motcore/animo/docs/walker-sim/img/duck_v1_cad.png

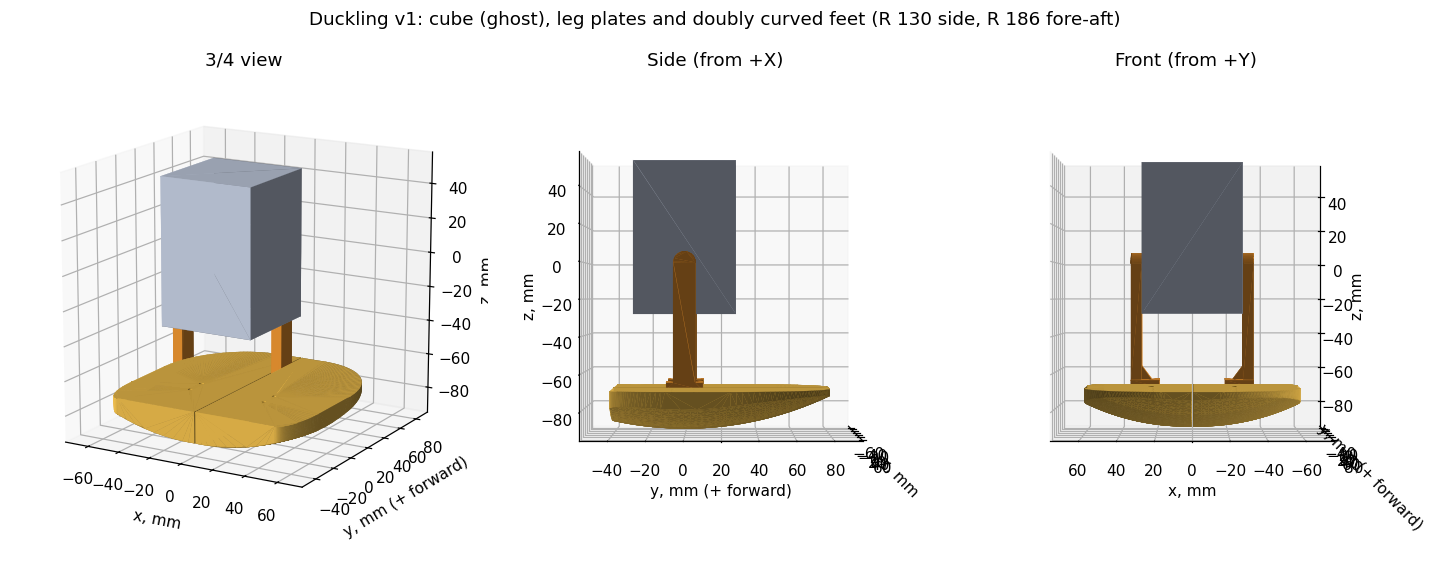
docs/walker-sim/img/duck_v1_cad.png
