motcore/animo/cad/stl/animo_dial/PETG/animo_dial_Pointer.stl

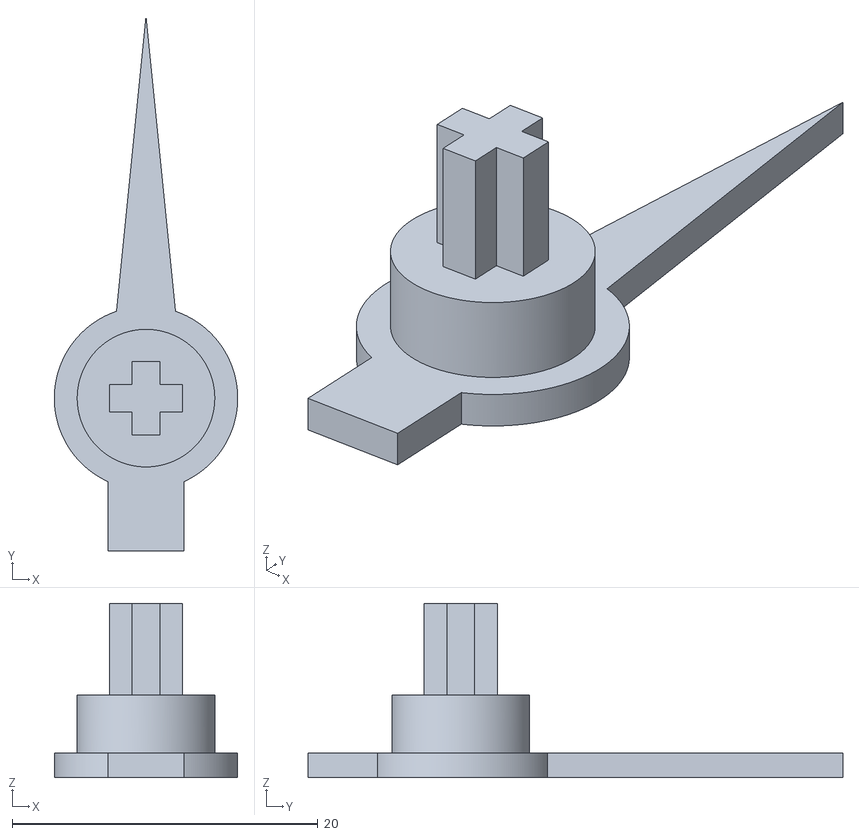
[picture p22: CAD file, 2026-11-01]
cad/stl/animo_dial/PETG/animo_dial_Pointer.stl
12.0 x 35.0 x 11.4
