motcore/animo/cad/stl/animo_duck/PETG/animo_duck_Plate.stl

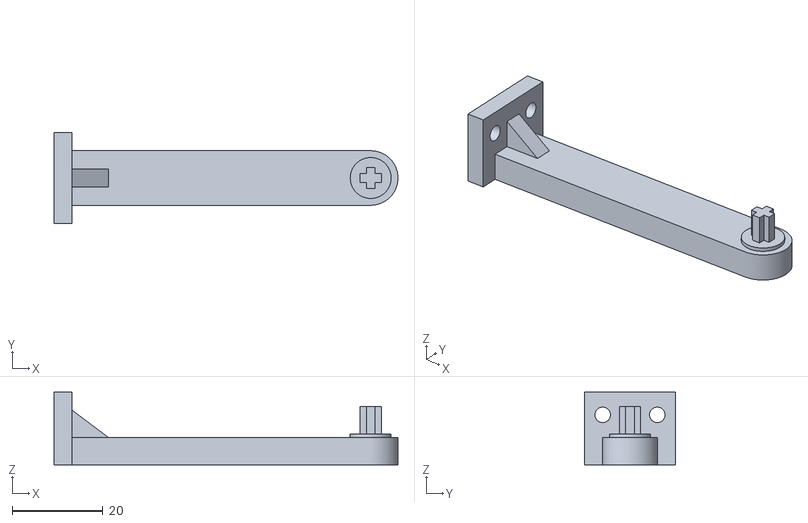
[picture p23: CAD file, 2026-11-02]
cad/stl/animo_duck/PETG/animo_duck_Plate.stl
75.6 x 20.0 x 16.0
