motcore/animo/cad/stl/animo_trex/PETG/animo_trex_LegRight.stl

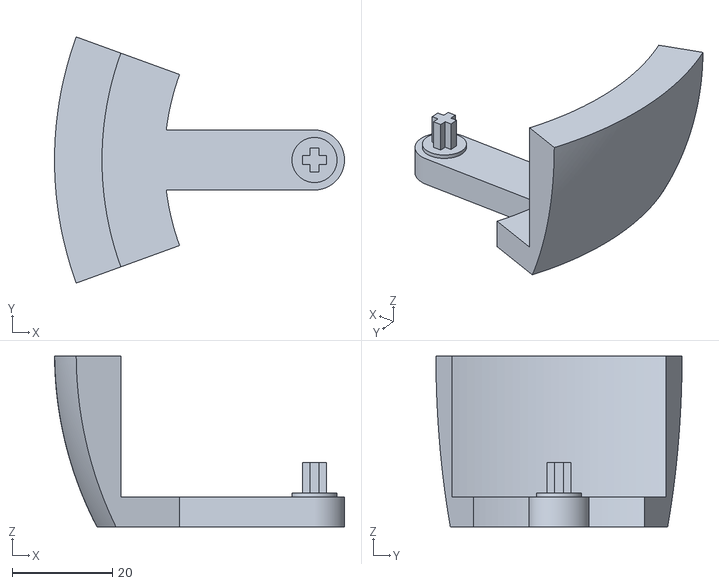
[picture p24: CAD file, 2026-10-28]
cad/stl/animo_trex/PETG/animo_trex_LegRight.stl
58.0 x 49.3 x 34.1
