motcore/animo/cad/stl/animo_v2/PETG/animo_v2_OutputHub.stl

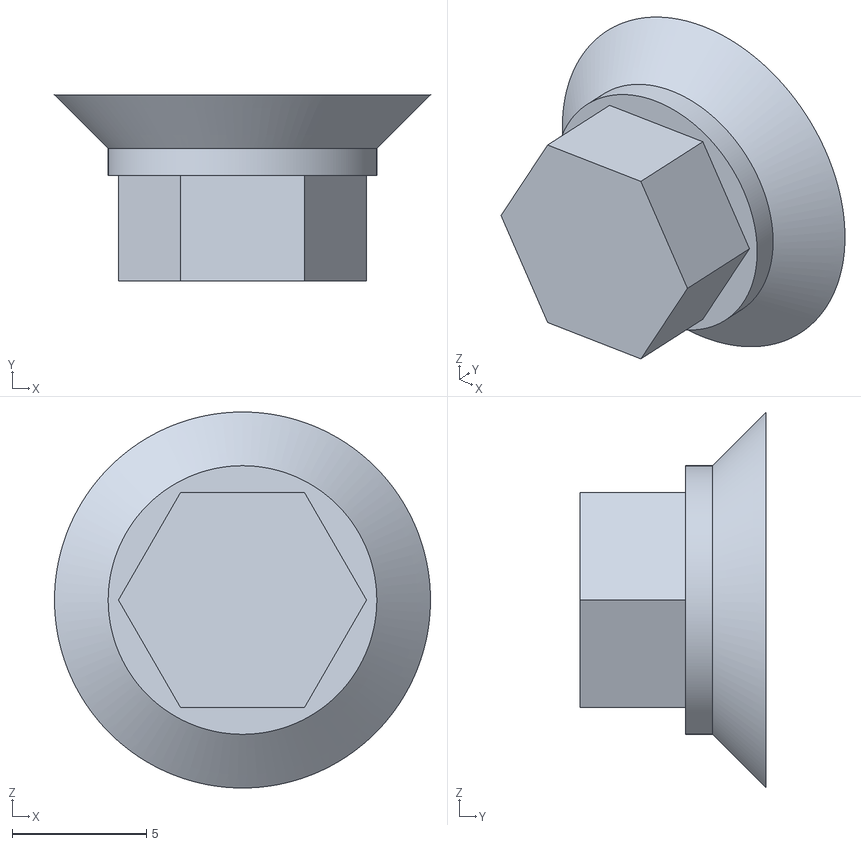
[picture p25: CAD file, 2026-10-28]
cad/stl/animo_v2/PETG/animo_v2_OutputHub.stl
14.0 x 6.94 x 14.0
