motcore/animo/cad/stl/coupon/animo_fit_technic_pin.stl

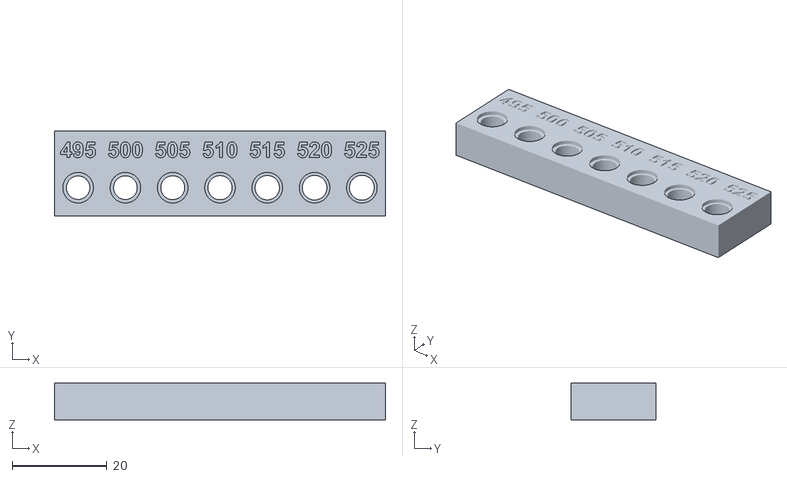
[picture p26: CAD file, 2026-10-20]
cad/stl/coupon/animo_fit_technic_pin.stl
70.0 x 18.0 x 7.80
