motcore/animo/cad/stl/animo_dial/PETG/animo_dial_Dial.stl

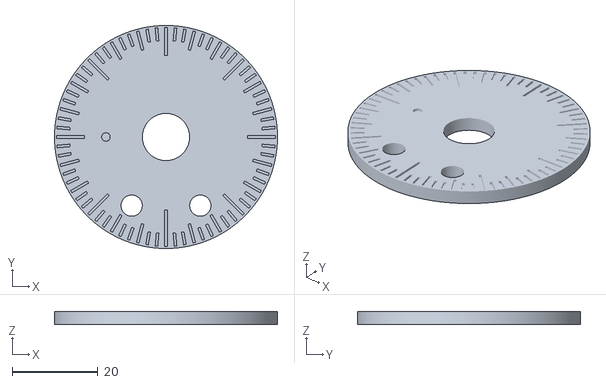
[picture p27: CAD file, 2026-11-01]
cad/stl/animo_dial/PETG/animo_dial_Dial.stl
52.0 x 52.0 x 3.00
