motcore/animo/cad/stl/animo_duck/PETG/animo_duck_SpigotCoupon.stl

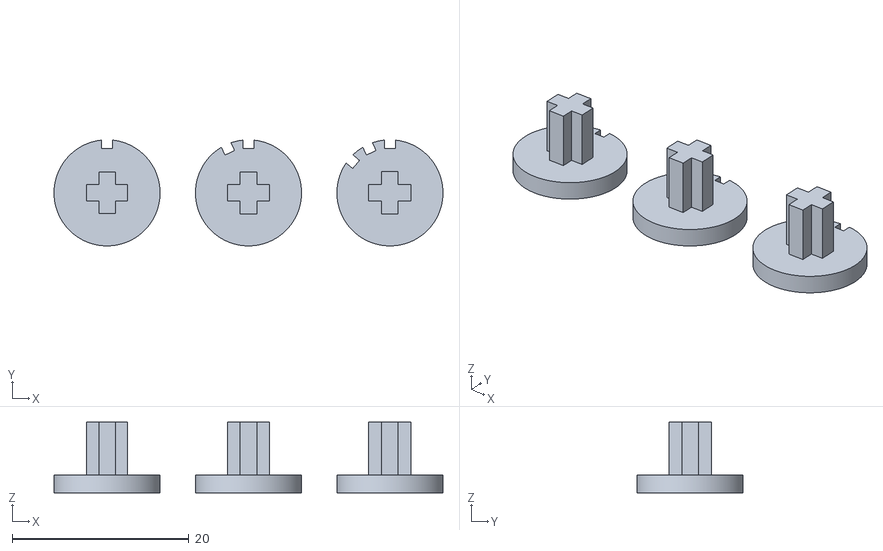
[picture p28: CAD file, 2026-11-02]
cad/stl/animo_duck/PETG/animo_duck_SpigotCoupon.stl
44.0 x 12.0 x 8.00
