motcore/animo/cad/stl/animo_v2/PETG/animo_v2_BrainBase.stl

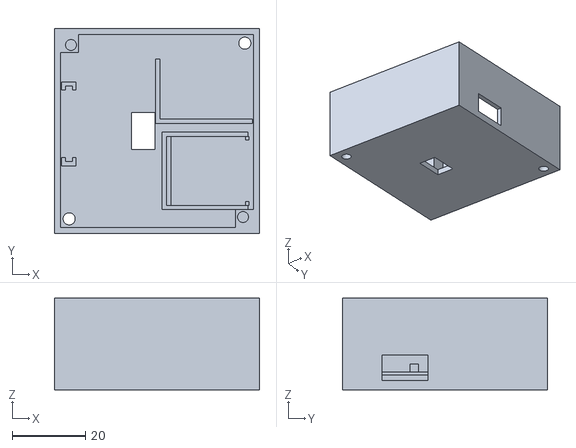
[picture p29: CAD file, 2026-10-25]
cad/stl/animo_v2/PETG/animo_v2_BrainBase.stl
56.0 x 56.0 x 25.0
