motcore/animo/cad/stl/coupon/animo_fit_technic_cross.stl

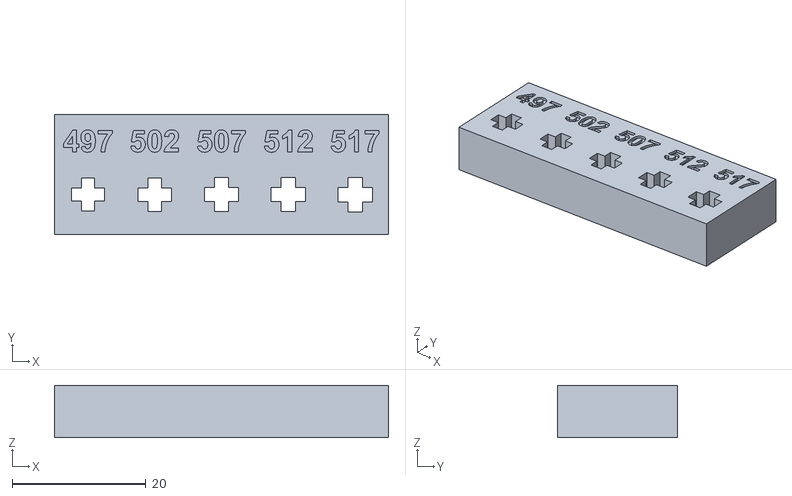
[picture p30: CAD file, 2026-10-20]
cad/stl/coupon/animo_fit_technic_cross.stl
50.0 x 18.0 x 7.80
