motcore/animo/cad/stl/animo_duck/PETG/animo_duck_FootRight.stl

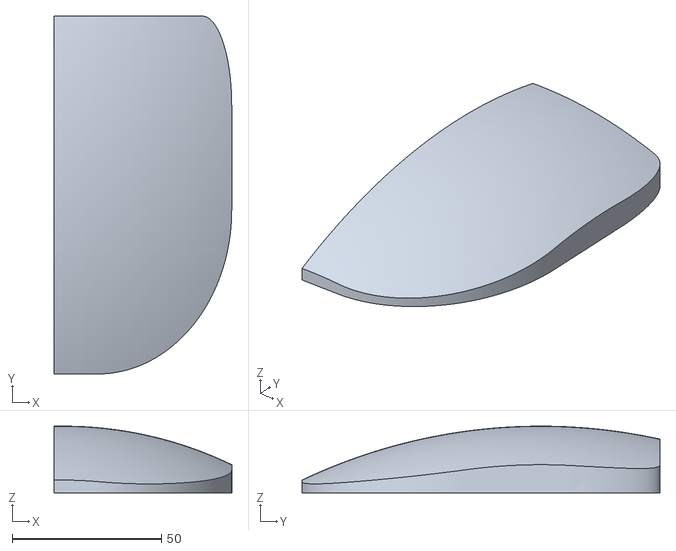
[picture p31: CAD file, 2026-11-02]
cad/stl/animo_duck/PETG/animo_duck_FootRight.stl
59.5 x 120.0 x 22.4
