motcore/animo/cad/stl/animo_trex/PETG/animo_trex_Tail.stl

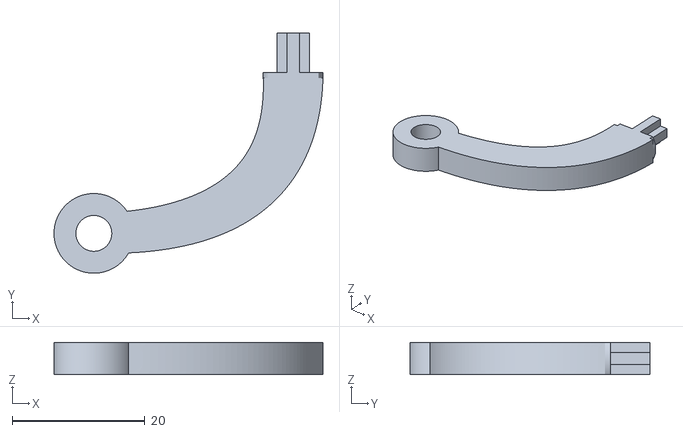
[picture p32: CAD file, 2026-10-28]
cad/stl/animo_trex/PETG/animo_trex_Tail.stl
40.5 x 36.2 x 4.86
