motcore/animo/cad/stl/animo_v2/PETG/animo_v2_BrainLid.stl

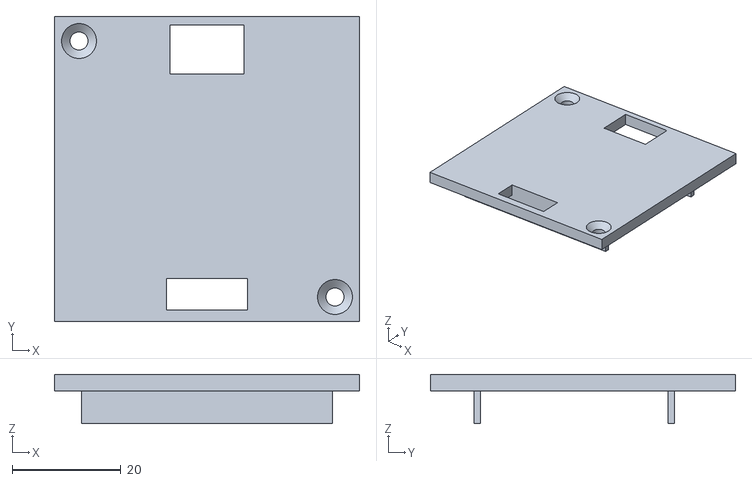
[picture p33: CAD file, 2026-10-23]
cad/stl/animo_v2/PETG/animo_v2_BrainLid.stl
56.0 x 56.0 x 9.00
