motcore/animo/cad/stl/coupon/animo_fit_mini_female_round.stl

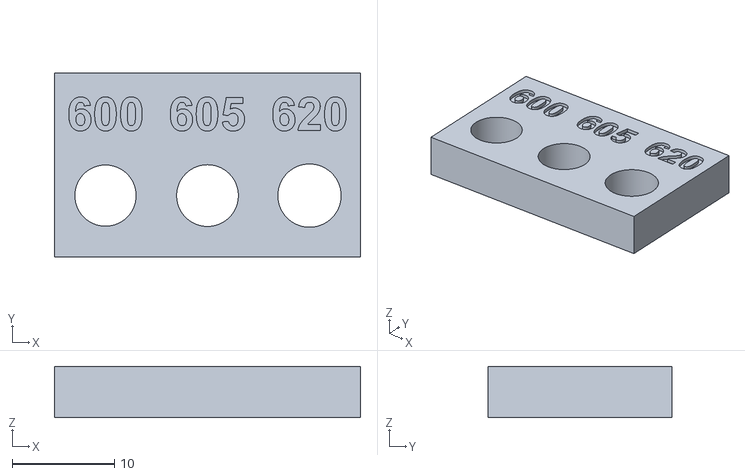
[picture p34: CAD file, 2026-10-20]
cad/stl/coupon/animo_fit_mini_female_round.stl
30.0 x 18.0 x 5.00
