motcore/animo/cad/stl/animo_v2/PETG/animo_v2_Deck.stl

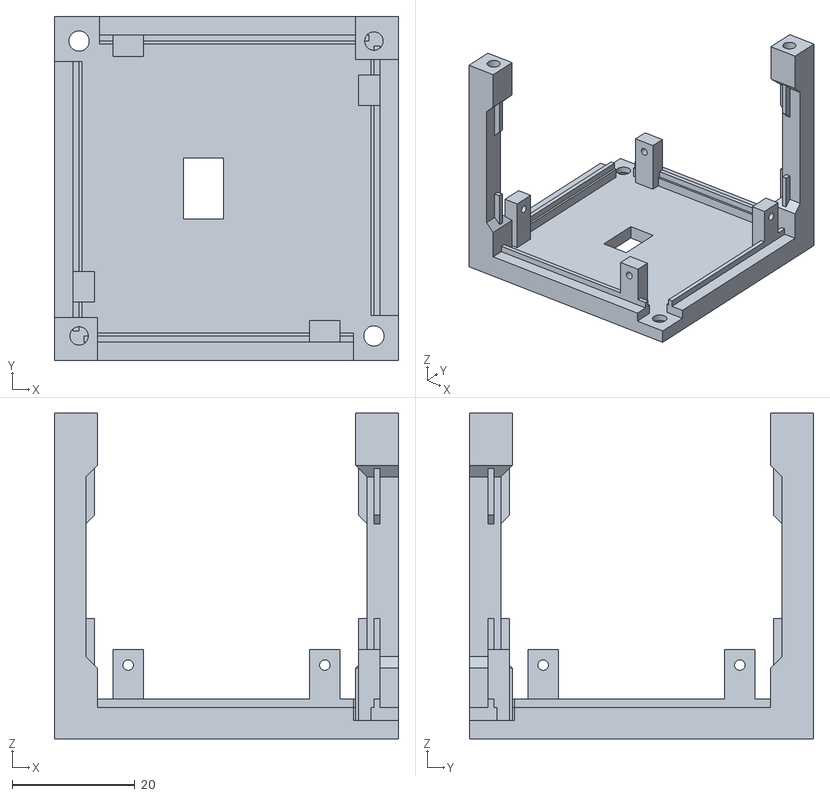
[picture p35: CAD file, 2026-10-20]
cad/stl/animo_v2/PETG/animo_v2_Deck.stl
56.0 x 56.0 x 53.0
