motcore/animo/cad/stl/coupon/animo_fit_mini_male_round.stl

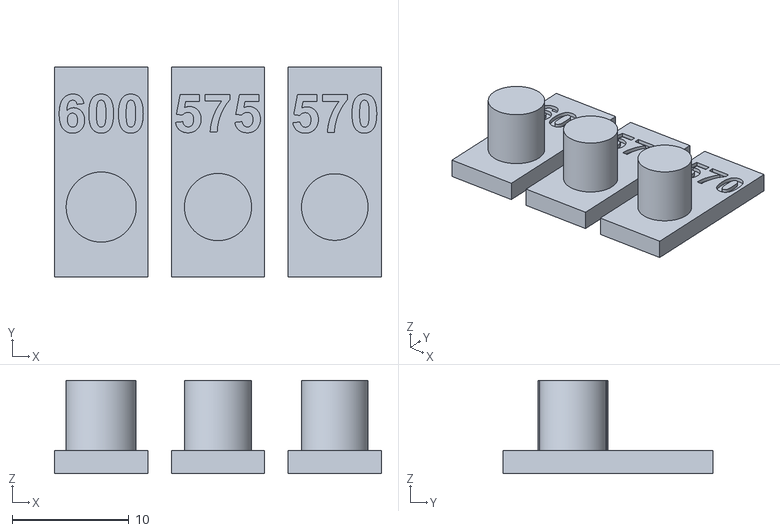
[picture p36: CAD file, 2026-10-20]
cad/stl/coupon/animo_fit_mini_male_round.stl
28.0 x 18.0 x 8.00
