motcore/animo/cad/stl/animo_v2/PETG/animo_v2_Wall.stl

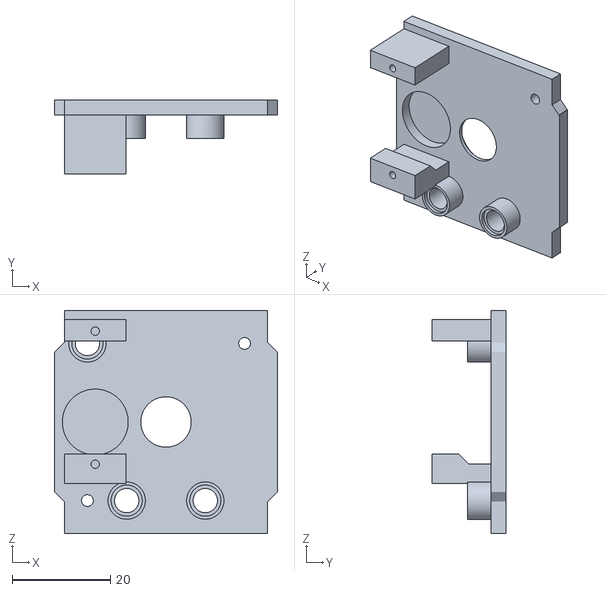
[picture p37: CAD file, 2026-10-20]
cad/stl/animo_v2/PETG/animo_v2_Wall.stl
45.4 x 15.0 x 45.4
