motcore/animo/cad/stl/animo_v2/PETG/animo_v2_OutputGear.stl

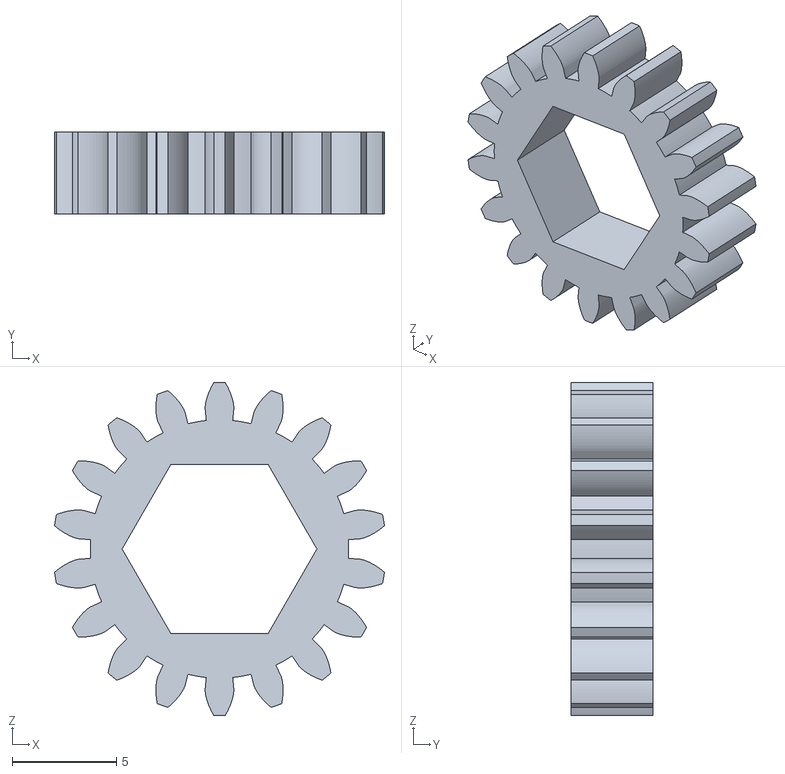
[picture p38: CAD file, 2026-10-20]
cad/stl/animo_v2/PETG/animo_v2_OutputGear.stl
15.8 x 3.94 x 16.0
