motcore/animo/cad/stl/animo_v2/PETG/animo_v2_ServoGear.stl

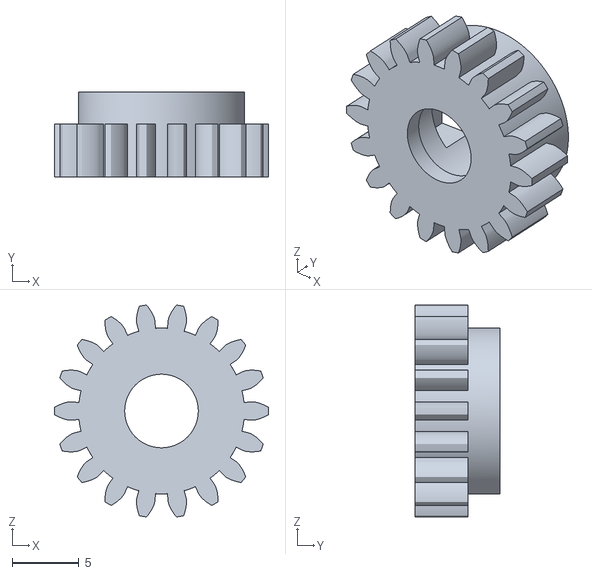
[picture p39: CAD file, 2026-10-20]
cad/stl/animo_v2/PETG/animo_v2_ServoGear.stl
16.0 x 6.34 x 15.8
