motcore/animo/(list of files, cad)

Other CAD files:
cad/stl/animo_trex/PETG/animo_trex_LegLeft.stl
cad/stl/animo_duck/PETG/animo_duck_FootLeft.stl
cad/stl/animo_trex/PETG/animo_trex_SpigotCoupon.stl
cad/stl/coupon/animo_fit_male_round.stl
cad/stl/coupon/animo_fit_male_square.stl
cad/stl/coupon/animo_fit_female_round.stl
cad/stl/coupon/animo_fit_female_square.stl
cad/stl/animo_v1/PETG/animo_v1_ModelArm.stl
cad/stl/animo_v1/PETG/animo_v1_ModelBase.stl
cad/stl/animo_v1/PETG/animo_v1_ModelShaft.stl
cad/stl/animo_v1/PETG/animo_v1_ModelShaft_D5.7.stl
cad/stl/animo_v1/PETG/animo_v1_OutputHub.stl
cad/stl/animo_v1/PETG/animo_v1_Wall.stl
cad/stl/animo_v1/PLA/animo_v1_ModelArm.stl
cad/stl/animo_v1/PLA/animo_v1_ModelBase.stl
cad/stl/animo_v1/PLA/animo_v1_ModelShaft.stl
cad/stl/animo_v1/PLA/animo_v1_ModelShaft_D5.7.stl
cad/stl/animo_v1/PLA/animo_v1_OutputHub.stl
cad/stl/animo_v1/PLA/animo_v1_ServoGear.stl
cad/stl/animo_v1/PLA/animo_v1_Wall.stl
