motcore/animo/cad/animo_fit_coupon.py

# Animo — fit coupon: round and square, a female strip and loose male pins each
# FreeCAD Python Macro
#
# Settles the PLA fits in one print instead of trial and error (user,
# 2026-10-18). Each feature is labelled with its DRAWN size in hundredths
# ("590" = 5.90), so a pair's drawn clearance is hole minus pin:
#   - FEMALE strip: holes 5.90 ... 6.40, through a 5 mm plate.
#   - MALE set: pins 6.10 ... 5.60, 6 mm tall, each on its own loose tile so
#     any pin goes into any hole (on one strip they only fit all at once).
# The two ranges overlap by 0.20 both ways, so the change from press to
# slide falls inside the coupon whatever the printer does to each.
# Try the 600 pin in every hole and every pin in the 600 hole: the first gives
# how holes print, the second how outsides print, so the macros can set
# both. For each, note: does not go in / press (by hand) / slides / turns
# with play. Square = the flat faces of the hex and the D.
#
# Printed as they lie: holes and pins vertical, like the parts they stand for.
# Run headless:
#   "C:/Program Files/FreeCAD 1.0/bin/freecadcmd.exe" animo_fit_coupon.py

import FreeCAD as App
import Part
import os

STEP    = 0.05    # mm
HOLES   = (5.90, 6.40)   # mm — first and last
PINS    = (6.10, 5.60)
N       = 11
PITCH   = 10.0    # mm between features
PLATE_T = 5.0     # mm — female plate
BASE_T  = 2.0     # mm — male tiles' base
PIN_H   = 6.0     # mm
WIDTH   = 18.0    # mm — strip width: feature row + label row
ROW_Y   = 6.0     # mm — feature centres from the strip's edge
LABEL_Y = 14.0    # mm — label centres
LABEL_H = 3.5     # mm — text height
TILE_W  = 8.0     # mm — male tiles, PITCH apart: 2 mm between them
ENGRAVE = 0.4     # mm
FONT    = "C:/Windows/Fonts/arialbd.ttf"

v = App.Vector


def feature(shape, size, x, z0, z1):
    """A round or square prism, vertical, centred at (x, ROW_Y)."""
    h = z1 - z0
    if shape == "round":
        return Part.makeCylinder(size / 2.0, h, v(x, ROW_Y, z0))
    return Part.makeBox(size, size, h, v(x - size / 2.0, ROW_Y - size / 2.0, z0))


def label(text, x, z_top):
    """Engraving cutter for `text`, centred at (x, LABEL_Y), from the top."""
    wires = Part.makeWireString(text, FONT, LABEL_H)
    faces = []
    for char in wires:
        for f in Part.makeFace(char, "Part::FaceMakerBullseye").Faces:
            faces.append(f)
    comp = Part.makeCompound(faces)
    bb = comp.BoundBox
    comp.translate(v(x - (bb.XMin + bb.XMax) / 2.0,
                     LABEL_Y - (bb.YMin + bb.YMax) / 2.0, z_top - ENGRAVE))
    return comp.extrude(v(0, 0, ENGRAVE + 1.0))


def length():
    return N * PITCH


def _sizes(first, sign):
    return [round(first + sign * i * STEP, 2) for i in range(N)]


def female(shape, sizes=None):
    sizes = sizes or _sizes(HOLES[0], 1)
    plate = Part.makeBox(len(sizes) * PITCH, WIDTH, PLATE_T)
    for i, size in enumerate(sizes):
        x = PITCH / 2.0 + i * PITCH
        plate = plate.cut(feature(shape, size, x, -1, PLATE_T + 1))
        plate = plate.cut(label(f"{round(size * 100)}", x, PLATE_T))
    return plate.removeSplitter()


def male(shape, sizes=None):
    sizes = sizes or _sizes(PINS[0], -1)
    tiles = []
    for i, size in enumerate(sizes):
        x = PITCH / 2.0 + i * PITCH
        tile = Part.makeBox(TILE_W, WIDTH, BASE_T, v(x - TILE_W / 2.0, 0, 0))
        tile = tile.cut(label(f"{round(size * 100)}", x, BASE_T))
        pin = feature(shape, size, x, BASE_T - 0.01, BASE_T + PIN_H)
        tiles.append(tile.fuse(pin).removeSplitter())
    return Part.makeCompound(tiles)


PARTS = [(f"{kind}_{shape}", (female if kind == "female" else male)(shape))
         for shape in ("round", "square") for kind in ("female", "male")]
# Mini coupon (2026-10-20): just the pieces that compared the two readings,
# to reprint quickly with another seam setting.
MINI_HOLES = [6.00, 6.05, 6.20]
MINI_PINS  = [6.00, 5.75, 5.70]
PARTS += [("mini_female_round", female("round", MINI_HOLES)),
          ("mini_male_round", male("round", MINI_PINS))]

# LEGO Technic coupon (2026-10-20): holes for real LEGO friction pins and
# axles, one module deep (7.8, a beam's thickness), the pin holes with a
# counterbore on both faces as on a LEGO beam. Labelled with the drawn size; the cube's macro
# draws them at LEGO size + 0.27 in PETG (pin 5.07, cross 5.07 / 2.07).
TECH_T      = 7.8
TECH_PINS   = [4.95, 5.00, 5.05, 5.10, 5.15, 5.20, 5.25]
TECH_CROSS  = [4.97, 5.02, 5.07, 5.12, 5.17]     # tip to tip; arms = tip - 3.0
TECH_CB     = (6.47, 0.8)                        # counterbore, as on the wall


def cross_z(span, arm, x, z0, z1):
    a = Part.makeBox(span, arm, z1 - z0, v(x - span / 2.0, ROW_Y - arm / 2.0, z0))
    b = Part.makeBox(arm, span, z1 - z0, v(x - arm / 2.0, ROW_Y - span / 2.0, z0))
    return a.fuse(b).removeSplitter()


def technic(kind):
    sizes = TECH_PINS if kind == "pin" else TECH_CROSS
    plate = Part.makeBox(len(sizes) * PITCH, WIDTH, TECH_T)
    for i, size in enumerate(sizes):
        x = PITCH / 2.0 + i * PITCH
        if kind == "pin":
            plate = plate.cut(feature("round", size, x, -1, TECH_T + 1))
            plate = plate.cut(feature("round", TECH_CB[0], x, TECH_T - TECH_CB[1],
                                      TECH_T + 1))
            # LEGO beams have it on both faces: the pin's ridge clicks into
            # the far one (7.1 in from the collar, the far one starts at 7.0)
            plate = plate.cut(feature("round", TECH_CB[0], x, -1, TECH_CB[1]))
        else:
            plate = plate.cut(cross_z(size, size - 3.0, x, -1, TECH_T + 1))
        plate = plate.cut(label(f"{round(size * 100)}", x, TECH_T))
    return plate.removeSplitter()


PARTS += [("technic_pin", technic("pin")), ("technic_cross", technic("cross"))]

_here = os.path.dirname(os.path.abspath(__file__)) if "__file__" in dir() \
    else App.getUserMacroDir(True)
_dir = os.path.join(_here, "stl", "coupon")
os.makedirs(_dir, exist_ok=True)
assert round(HOLES[0] + (N - 1) * STEP, 2) == HOLES[1]
assert round(PINS[0] - (N - 1) * STEP, 2) == PINS[1]
for name, shape in PARTS:
    assert shape.isValid(), name
    if "male" in name and "female" not in name:
        assert len(shape.Solids) == (3 if name.startswith("mini") else N), name
    shape.exportStl(os.path.join(_dir, f"animo_fit_{name}.stl"))
    bb = shape.BoundBox
    print(f"  {name}: {bb.XLength:.0f} x {bb.YLength:.0f} x {bb.ZLength:.0f} mm,"
          f" {shape.Volume / 1000:.1f} cm3")

if getattr(App, "GuiUp", 0):
    doc = App.newDocument("AnimoFitCoupon")
    for i, (name, shape) in enumerate(PARTS):
        s = shape.copy()
        s.translate(v(0, i * (WIDTH + 5), 0))
        doc.addObject("Part::Feature", name).Shape = s
    doc.recompute()
