motcore/animo/firmware/duck_walk.py

# Duckling walker v1 (O2.2-a): two legs on the side walls, nothing else.
# Open loop, no sensors: the legs swing in scissors, +-LEG_DEG at FREQ, and
# the body rocks side to side on the doubly curved feet (cad/animo_duck.py).
# The values are the simulator's (sim/trex_sim.py, 2026-10-31; the study in
# docs/walker-sim/).
#
# MODE = "park": both legs to their centre, one at a time, and hold. Put the
#   legs on hanging straight down while it holds.
# MODE = "walk": the legs grow to full swing over FADE_S and keep going.
# MODE = "sweep_freq": walking through SWEEP_FREQ, STEP_S each. Before each
#   step the legs stop 2 s and the LED blinks the step's number (1, 2...).
#   Changes the rhythm without a USB upload for each try.
#
# Angles go through cal.py (the dial's readings, firmware/calibrate.py), so
# both legs swing the same; without it, the nominal US_PER_DEG. Which plug
# drives which wall differs per cube: fill PINS by hand (notas/montaje-patito.md).
# SIGN follows from the geometry: cal's + is clockwise seen from outside, so
# a foot forward (+Y) is - on the right wall (+X) and + on the left.
# The Wi-Fi radio stays on to keep the DAOKAI awake (O1.2-f).
# Copy it as main.py to run it from the battery. With a computer on the USB
# it sends no pulses (usb_host: the USB's 5 V reaches the servos through the
# ESP32's 5V pin), so they can stay plugged in, the switch OFF:
#   mpremote connect COM4 cp duck_walk.py :main.py
#   mpremote connect COM4 cp cal.py :cal.py

import math
import machine
import network
import time
from machine import Pin, PWM

MODE = "walk"

PINS = {"right": 7, "left": 4}          # GPIO: east and west, walking north (the switch)
SIGN = {"right": -1, "left": 1}         # cal's + (clockwise from outside) -> foot forward
TRIM = {"right": 0, "left": 0}          # us: on top of cal.py, 0 once calibrated

US_PER_DEG = 10.0       # MG90D: ~1000 us for ~90 deg - only without cal.py
# The simulator (2026-10-31): +-15 deg at 1.2 Hz walks ~10 cm/s on the
# rounded feet; the window is about +-5 % of rhythm. The right leg starts
# going BACK (phase 180): that start picks "forward" most often (~4 in 5;
# the rest walk backward or fall - pick it up and start again).
FREQ = 1.2              # Hz
LEG_DEG = 15            # the legs' swing each way (checked to 25: the macro's)
PHASE = 180             # deg: 180 = the right leg starts going back
LEAN = 0                # deg: both legs turned together, + = feet forward
FADE_S = 2              # s: the swing grows from 0 over this
SWEEP_FREQ = (1.10, 1.15, 1.20, 1.25, 1.30)
STEP_S = 20
START_FREQ = 1.0        # Hz: the start. Slower, the body rocks wider (2026-11-02,
START_S = 5             # with the ballast); held this long, then FREQ over RAMP_S
RAMP_S = 12

led = Pin(8, Pin.OUT, value=1)
time.sleep(1)                           # let the supply settle


def usb_host():
    """True with a computer on the ESP32's USB: its USB block counts the
    host's frames, one a millisecond (USB_SERIAL_JTAG_FRAM_NUM_REG, C3)."""
    n = machine.mem32[0x60043024] & 0x7FF
    time.sleep_ms(5)
    return (machine.mem32[0x60043024] & 0x7FF) != n


if usb_host():                          # on USB: the plugged servos would draw
    for p in PINS.values():             # from it - no pulses, fast blink, and
        Pin(p, Pin.OUT, value=0)        # mpremote can copy with them plugged
    while True:
        led.value(not led.value())
        time.sleep(0.1)

ap = network.WLAN(network.AP_IF)        # keeps the DAOKAI awake
ap.active(True)
ap.config(essid="animo-duck")

try:
    import cal
    to_us = cal.us
except ImportError:                     # not calibrated: nominal, + us = clockwise
    def to_us(pin, deg):
        return 1500 + deg * US_PER_DEG

servo = {}
for name in ("right", "left"):          # one at a time: servos jumping to
    servo[name] = PWM(Pin(PINS[name]), freq=50)   # centre at once reset
    servo[name].duty_ns(int((to_us(PINS[name], 0) + TRIM[name]) * 1000))  # the ESP32 (2026-10-26)
    time.sleep(0.5)


def put(name, deg):
    us = to_us(PINS[name], SIGN[name] * deg) + TRIM[name]
    servo[name].duty_ns(int(us * 1000))


if MODE == "park":
    while True:                         # slow blink: parked
        led.value(0)
        time.sleep(0.1)
        led.value(1)
        time.sleep(1.9)


def walk(freq, secs=None):
    """Legs from still, the swing growing over FADE_S; for secs, or for ever."""
    t0 = time.ticks_ms()
    w = last = 0
    while True:
        t = time.ticks_diff(time.ticks_ms(), t0) / 1000
        if secs and t > secs:
            return
        f = freq                        # walking for ever: the slow start first
        if not secs and t < START_S + RAMP_S:
            f = START_FREQ + (freq - START_FREQ) * max(0, t - START_S) / RAMP_S
        w += 2 * math.pi * f * (t - last)
        last = t
        legs = LEG_DEG * min(1.0, t / FADE_S)
        lean = LEAN * min(1.0, t / 2)
        step = legs * math.sin(w - math.radians(PHASE))
        put("right", lean + step)       # one forward, the other back
        put("left", lean - step)
        led.value(0 if step > 0 else 1)  # LED on: right foot ahead
        time.sleep_ms(20)


def pause(n):
    put("right", LEAN)
    put("left", LEAN)
    time.sleep(0.5)
    for _ in range(n):
        led.value(0)
        time.sleep(0.15)
        led.value(1)
        time.sleep(0.25)
    time.sleep(max(0, 1.5 - 0.4 * n))


if MODE == "sweep_freq":
    while True:
        for i, f in enumerate(SWEEP_FREQ):
            pause(i + 1)
            walk(f, STEP_S)
else:
    walk(FREQ)
