motcore/animo/(commit log)

2026-10-15 Animo v1: the configurable cube, first full draft
    A 57.9 mm cube with four identical wall modules (MG90D or MG90S 360),
    servos standing in a pinwheel round the centre, 1:1 spur gears to a
    flush female-D output on each wall centre, flush model magnets, walls
    held by tongue and groove between two identical decks, and a half-cube
    brain (ESP32-C3, TP4056, 5 V boost, 1S LiPo) replacing the top deck.
    The FreeCAD macro checks every pair of parts for interference.
    [animo_v1_BrainBase.stl, animo_v1_BrainLid.stl, animo_v1_Deck.stl, animo_v1_OutputGear.stl, animo_v1_OutputHub.stl, animo_v1_ServoGear.stl, animo_v1_Wall.stl]
2026-10-15 Brain: board cradles and the battery frame
    Each board drops into a cradle on the brain's floor (wall, ledge, two
    snap lips), its USB end against the box wall; the switch shares cradle
    walls with its neighbours. The battery sits in a frame under the lid on
    foam tape. No screws, no glue. Board sizes are still catalogue figures.
    [animo_v1_BrainBase.stl, animo_v1_BrainLid.stl]
2026-10-16 Brain: 3 A rocker switch instead of the mini slide switch
    The power switch carries the servos' current, which a mini slide switch
    (0.5 A) cannot. A KCD11 mini rocker (3 A) snaps into a cutout in the +Y
    wall, lying on its side under the battery. Sizes from listings.
    [animo_v1_BrainBase.stl]
2026-10-16 Model magnets: 6 x 2 instead of 4 x 2
    Stronger hold for the models (user's choice). The magnets move in from
    the plate's edge so their bosses stay on the plate.
    [animo_v1_Wall.stl]
2026-10-16 Brain: 3 mm foam pad under the battery
2026-10-16 Servo gear: print it servo side down
2026-10-16 Brain as a separate half cube on the closed cube
    The cube closes with its two identical decks again; the brain is its own
    box (2 mm floor, walls, lid) on the top deck, held by two M3x12 cap
    screws through its floor and the top deck into the bottom deck's
    columns. Its boards are now the ones bought: ESP32-C3 and a charge +
    5 V boost board (25 x 20 placeholder). The cable passage moves off
    centre in X so the cradles clear it.
    [animo_v1_BrainBase.stl, animo_v1_Deck.stl]
2026-10-16 Tree: every board goes in the brain's group
    The group list named the old boards; it now takes them from BOARDS.
2026-10-16 Test model: the template every model starts from
    A base the wall's magnets hold (four magnets of its own) and an arm the
    output turns through it: male D, flange in a pocket on the base's wall
    side, a pointer to read the angle. Checked against the socket, the base
    and the wall.
    [animo_v1_ModelArm.stl, animo_v1_ModelBase.stl]
2026-10-17 Wall: lower tab post steps up at 45 deg
    The step where the post widens toward the servo's tab is now a 45 deg
    slope on the tab's side, so the wall prints outer face down without an
    overhang. The tab screw keeps its full material.
    [animo_v1_Wall.stl]
2026-10-17 Wall: conical hub seat and 45 deg tongues, no overhangs
    The first print strung at the hub's flat counterbore step and under the
    tongues. The hub's flange and its seat are now 45 deg cones (which also
    centre the hub), and each tongue's bed-side face slopes at 45 deg; the
    decks' grooves are unchanged.
    [animo_v1_OutputHub.stl, animo_v1_Wall.stl]
2026-10-17 Servo gear: more room round the horn's hub
    The horn's hub tapers and bottomed out in a 0.2 pocket on the first
    print. The hub pocket gets 0.4 a side; the arms, which key the gear,
    keep their 0.2.
    [animo_v1_ServoGear.stl]
2026-10-17 Servo gear: back to a 0.2 press fit on the horn's hub
    Pushed hard, the horn seats perfectly in the original pocket (tested).
    [animo_v1_ServoGear.stl]
2026-10-17 Output gear: hex hole 8.1 for a press fit
    8.25 went on loose: flat faces barely shrink in print, unlike small
    round holes.
    [animo_v1_OutputGear.stl]
2026-10-17 Square walls, tongued on all four edges; M3 pilots 3.0
    The wall plate is square: framed on every side by a band a column wide,
    the columns at the sides and a skirt of each deck at top and bottom.
    Every edge carries a 45 deg tongue in a groove (decks' skirts and the
    columns), so the cube closes with no gaps; assembly stays vertical.
    The M3 pilots go to 3.0, the T1.1 figure: 2.5 had to be opened by hand.
    [animo_v1_BrainBase.stl, animo_v1_Deck.stl, animo_v1_Wall.stl]
2026-10-17 Material switch: PLA or PETG fits, one STL set each
    MATERIAL (or ANIMO_MATERIAL headless) picks the fits that differ: PETG
    opens the round holes 0.1 mm, from its coupons; flat faces and the M3
    thread stay. STLs go to stl/animo_v1/PLA/ and .../PETG/.
    [animo_v1_BrainBase.stl, animo_v1_BrainLid.stl, animo_v1_Deck.stl, animo_v1_ModelArm.stl, animo_v1_ModelBase.stl, animo_v1_OutputGear.stl, animo_v1_OutputHub.stl, animo_v1_ServoGear.stl]
2026-10-17 Brain: the boards, switch and battery as measured
    ESP32-C3 22.0 x 18.2 with its USB-C 1.9 proud, set back so the socket
    meets the wall, behind a window big enough for the plug's overmould.
    The DAOKAI (25 x 16, no USB, only 0.4 clear by its long edges) sits on
    a foam pad in a cradle open on its button's side. A panel-mount USB-C
    for charging joins the +X wall (placeholder size). The KCD11, measured,
    moves to the -X wall. The battery is 52 long: two rails under the lid
    hold its sides, the box walls its ends.
    [animo_v1_BrainBase.stl, animo_v1_BrainLid.stl]
2026-10-17 Brain: plain sides, switch and charging socket in the lid
    The KCD11 and the charging USB-C move to the lid, one in each strip the
    battery leaves along its long sides, wired with slack. The ESP32's own
    USB-C stays inside, turned toward the open floor: it is only for the
    first flash, lid off; programs come over the air after that.
    [animo_v1_BrainBase.stl, animo_v1_BrainLid.stl]
2026-10-17 Brain: ESP32's USB-C back at the +X side, behind its window
    Easier to change the firmware (user). Switch and charging socket stay in
    the lid.
    [animo_v1_BrainBase.stl]
2026-10-18 Firmware: servo test for the ESP32-C3 (MicroPython)
2026-10-18 Test model: arm in two, shaft through the base and the arm pressed on its hex
    The one-piece arm could never go through the base: flange on one side,
    lever on the other. The arm's hex hole is 8.0, tighter than the gear's 8.1.
    [animo_v1_ModelArm.stl, animo_v1_ModelShaft.stl]
2026-10-18 Magnet holes 6.3: 6.2 held only one magnet in four
    [animo_v1_ModelBase.stl, animo_v1_Wall.stl]
2026-10-18 Magnets sit on a lip: the bridged pocket floor sagged and they stood proud
    [animo_v1_ModelBase.stl, animo_v1_Wall.stl]
2026-10-18 Test model: tighter male D, shaft without overhang, arm hex 8.05
    The male D rocked 25-30 deg: 5.8 / 4.6 now (0.1 round and on the flat),
    and a 5.7 / 4.5 shaft to try beside it. The flange is a rim with a 45 deg
    cone under it and the base's pocket a countersink: no support, no bridge.
    The arm's hex hole 8.0 went on only with a hammer: 8.05.
    [animo_v1_ModelArm.stl, animo_v1_ModelBase.stl, animo_v1_ModelShaft.stl, animo_v1_ModelShaft_D5.7.stl]
2026-10-18 Fit coupon: round and square, male and female strips; model D 5.9 and 6.0, arm hex 8.15
    One print settles the PLA fits (holes 6.00-6.40, pins 6.00-5.60, labelled
    in hundredths) instead of trial and error. Meanwhile the model's D: 5.8
    still rocked 12-14 deg, so 5.9 and a 6.0 to try; the arm's hex 8.05 was
    still too hard: 8.15.
    [animo_fit_female_round.stl, animo_fit_female_square.stl, animo_fit_male_round.stl, animo_fit_male_square.stl, animo_v1_ModelArm.stl, animo_v1_ModelShaft.stl, animo_v1_ModelShaft_D6.0.stl]
2026-10-18 Fit coupon: each male pin on its own loose tile
    On one strip the pins only fit the holes all at once, each in the one
    opposite; loose, any pin goes into any hole.
    [animo_fit_male_round.stl, animo_fit_male_square.stl]
2026-10-18 Fit coupon: overlapping ranges, labels are the drawn size
    Holes 5.90-6.40 and pins 6.10-5.60, so the change from press to slide
    falls inside whatever the printer does; "590" = 5.90, clearance = hole
    minus pin.
    [animo_fit_female_round.stl, animo_fit_female_square.stl, animo_fit_male_round.stl, animo_fit_male_square.stl]
2026-10-19 Model arm: hex hole 8.20 from the fit coupon
    Round presses at +0.20 and square at +0.30; a hex lies between, and the
    arm takes the firm end. 8.05 was still too hard.
    [animo_v1_ModelArm.stl]
2026-10-19 Model D: note the measured socket and males
2026-10-19 Model D 5.9 / 4.7 confirmed in PLA: no play with arc moves off
    [animo_v1_ModelShaft_D6.0.stl]
2026-10-19 Model arm: hex 8.15, between 8.05 (too hard) and 8.20 (slides)
    [animo_v1_ModelArm.stl]
2026-10-20 Fit coupon: a mini set (holes 6.00/6.05/6.20, pins 6.00/5.75/5.70) to retry seams
    The two readings of the PETG coupon disagree by 0.05-0.1, most likely the
    seam's ~0.2 bump; the mini set reprints just those pieces quickly.
    [animo_fit_mini_female_round.stl, animo_fit_mini_male_round.stl]
2026-10-20 v2: LEGO Technic faces; Technic fit coupon
    The cube's faces become LEGO Technic: a cross hole in the output hub and
    four pin holes on the 8 mm grid at (+-16, +-16), on bosses one module deep,
    drawn at LEGO size + 0.27 in PETG. The magnets and the D are gone (loose
    magnets are a hazard; the D had to be aimed by hand). PETG is the default
    material now, with the fits the PETG coupon gave (press +0.05, sliding
    +0.25). LEGO pins and axle are drawn as ghosts and checked clear.
    A Technic coupon tries real LEGO pins and axles in a range of holes.
    [animo_fit_technic_cross.stl, animo_fit_technic_pin.stl, animo_v2_BrainBase.stl, animo_v2_BrainLid.stl, animo_v2_Deck.stl, animo_v2_OutputGear.stl, animo_v2_OutputHub.stl, animo_v2_ServoGear.stl]
2026-10-20 v2: 56 mm cube (7 LEGO modules); pins in a row under the output
    A 0.6 skin behind the servo gear's recess (3 layers, printed on the bed)
    and 0.2 axial gaps take the cube from 57.9 to 56.0, with the horn at its
    measured height (tower to its top 6.34). In 56 the pin column at x = +16
    meets the neighbour servo, so the five pin holes are a row of four under
    the output and one above, all clear by 3.2 or more.
    Known open: the brain box shrinks with the cube and no longer holds the
    battery, switch and charging socket; it gets its own redesign.
    [animo_v2_BrainBase.stl, animo_v2_BrainLid.stl, animo_v2_Deck.stl, animo_v2_OutputGear.stl, animo_v2_OutputHub.stl, animo_v2_ServoGear.stl, animo_v2_Wall.stl]
2026-10-20 v2: four pins, three under the output every other hole and one above
    At (+16, -16) the boss is cut to 7.0 to clear the neighbour wall; the pin's
    tip stands 0.8 out behind, 0.9 clear. All pins clear by 1.1 or more.
    [animo_v2_Wall.stl]
2026-10-20 Technic pin holes counterbored on both faces, as on a LEGO beam
    The pin goes 7.1 past its collar and its ridge clicks into the beam's far
    counterbore, which starts at 7.0; with a plain hole to 7.8 it might not
    click. Wall bosses and the Technic coupon get it; the short boss at
    (+16, -16) ends at 7.0, which does the same.
    [animo_fit_technic_pin.stl, animo_v2_Wall.stl]
2026-10-20 v2: LEGO pin holes 4.95, from the Technic coupon
    On the PETG Technic coupon a 4.95 hole felt most like a real LEGO beam (5.00
    close behind). The counterbores follow (6.35). The axle's cross stays at
    LEGO + 0.27 until it is tried.
    [animo_v2_Wall.stl]
2026-10-20 v2: output's cross hole 4.97 / 1.97, from the Technic coupon
    [animo_v2_OutputHub.stl]
2026-10-20 v2: walls swap without opening the cube
    No tongues or grooves: each wall module (wall, servo, gears, hub) slides
    straight out through its window, checked in the macro over 31 mm. Two M2x6
    countersunk screws in the face, on one diagonal of the 8 mm grid, hold it
    to bosses on the decks (5 wide, 3.5 deep: the room there). The decks stay
    one part: turned over, the bottom deck's boss lands on the opposite wall's
    upper corner. Three LEGO pins: two under the output at +-8, one in the
    upper corner on the servo gear's side. M2 pilots 1.7 in PETG.
    [animo_v2_Deck.stl, animo_v2_Wall.stl]
2026-10-20 v2: column feet round the deck screws
    In the 56 mm cube the corner columns shrank to 5.1 and the M3 pilot, 4 in
    from the outer edges, broke out of their inner faces. Each column's free
    end, where the other deck's screw goes in, widens to 7.0 for 5 mm with a
    45 deg flare under it (prints without support): 1.5 of plastic round the
    pilot. The walls' corners are notched round the feet (all four, so the
    walls stay alike); the modules still slide out clear (0.34).
    [animo_v2_Deck.stl, animo_v2_Wall.stl]
2026-10-20 v2: no gaps round the walls: feet at both column ends, a lip behind the plate
    Every column now widens at both ends, so all four notched corners of every
    wall are closed by a foot. The frame carries a 1.2 x 1.0 lip behind the
    plate's edges: the 0.2 gap no longer shows through and the plate stops on
    it going in, while the module still slides out. The side lips break off
    within 8.4 of the centre, where the servo gear passes (one deck part means
    any column side may face a servo-gear side).
    [animo_v2_Deck.stl]
2026-10-20 v2: wall corners notched to the feet's own shape
    A square notch left a triangle open at each foot's 45 deg flare. The notch
    is now the foot itself, flare and all, grown by 0.3.
    [animo_v2_Wall.stl]
2026-10-20 v2: side lips' upper stretch grows out of the column at 45 deg
    The slicer flagged floating regions on the deck: the upper stretch of each
    side lip began in mid air at +8.4 (as printed), held only by a 0.01 overlap
    with the column. It now starts on a 45 deg underside from the column face
    and sinks 0.3 into it.
    [animo_v2_Deck.stl]
2026-10-20 v2: column feet 8.5 long, past the M3 pilot
    At 5 (+1.9 flare) the 8 mm M3 pilot broke out of the plain 5.1 column under
    the foot, leaving floating slivers the slicer flagged. 8.5 keeps the whole
    pilot in the widened end; the modules still slide out clear.
    [animo_v2_Deck.stl, animo_v2_Wall.stl]
2026-10-20 v2: decks make room for each other's column feet; M3 pilots 3.1 in PETG
    The 7.0 feet landed on the other deck's skirt and lip at the corners where
    it has no column, so a printed pair would not close; the check missed it
    because the decks were allowed to touch. Each deck is now cut, above its
    plate, to the other's feet grown by 0.3, and the decks are checked against
    each other (they touch, no overlap). M3 pilots 3.1 in PETG (T1.2).
    [animo_v2_BrainBase.stl, animo_v2_Deck.stl]
2026-10-20 v2: output cross 4.92 / 1.92, and a 4.87 hub to try
    The coupon's best cross, 4.97, was its smallest; in the hub, 6.5 deep, a
    LEGO axle went in too loose. One step tighter, and a hub one more step
    down to bracket it.
    [animo_v2_OutputHub.stl, animo_v2_OutputHub_X487.stl]
2026-10-20 v2: M3 pilots back to 3.0 in PETG: the printed decks took them just right
    [animo_v2_BrainBase.stl, animo_v2_Deck.stl]
2026-10-21 v2: the charging USB-C as measured
    LYMISPIYA panel USB-C (+0.04): body 12.00 x 5.39, 9.10 deep under a
    15.71 x 9.25 x 1.90 bezel; its clips are wedges from the bezel back, so
    the 3 mm lid holds it. Lid cutout 12.25 x 5.64 (PETG sliding fit). It no
    longer meets the brain box.
    [animo_v2_BrainLid.stl]
2026-10-21 v2: output cross 4.87 / 1.87: of the two hubs printed, the tighter one
    [animo_v2_OutputHub.stl, animo_v2_OutputHub_X487.stl]
2026-10-21 v2: the brain fits the 56 mm cube
    Brain walls 1.6 (four perimeters): inside 52.8, so the 52 mm battery has
    0.4 at each end. The battery sits 1.6 toward the charging socket, which
    widens the switch's strip to 9.7 for its 8.4 body; the socket moves 0.4
    out to clear the battery's rail. No interference left in the whole cube.
    [animo_v2_BrainBase.stl, animo_v2_BrainLid.stl]
2026-10-21 Firmware: power test, Wi-Fi on and a blinking LED
    The DAOKAI's 5 V boost switches itself off within seconds with an idle
    ESP32-C3 (too little current), leaving it ~2 V. With the Wi-Fi radio on it
    stays on; this test shows it (blue LED blinking = running).
2026-10-21 Firmware: first servo on the battery, standalone
    DAOKAI 5 V feeds the ESP32-C3 and one servo; Wi-Fi on keeps the boost
    awake. Runs from main.py with no PC: the servo sweeps 1000/1500/2000 us,
    no resets, the DAOKAI stays on (2026-10-21).
    [servo_battery_test.py]
2026-10-22 v2: the split board in the brain
    A 12 x 9 scrap of perfboard stands in two slotted posts on the brain's -X
    wall, a 3 x 4 header block on it. The four servo plugs go in sideways,
    stacked, under the battery, and end at the cable passage, so each servo
    cable comes up through it straight into its plug. Power rows from the
    DAOKAI through the switch; signals to GPIO 4-7. Checked clear of the
    battery, the DAOKAI, the ESP32, the switch and the lid.
    [animo_v2_BrainBase.stl]
2026-10-22 v2: DAOKAI cradle open toward +Y, where its button really is
    Laid component side up with its pads toward the split board, the DAOKAI's
    side button faces +Y (checked on the board), so its cradle opens there.
    The closed -Y wall now meets the servo plugs: the plug stack moves 1.5
    toward -Y, still into the cable passage. No interference.
    [animo_v2_BrainBase.stl]
2026-10-22 v2: DAOKAI against the +X wall, its charge LEDs beside the USB window
    Its four charge-level LEDs sit centred on the end opposite its pads; that
    end now goes against the brain's +X wall (0.29 off it), next to the ESP32's
    USB window, so both show on one side. It sits above the ESP32, 1.64 clear
    of the brain's M3 head, 0.65 under the battery; its cradle opens to +X and
    +Y (the button). The window over the LEDs waits for their measurements.
    [animo_v2_BrainBase.stl]
2026-10-22 v2: provisional slot in the brain's +X wall over the DAOKAI's LEDs
    9 x 2.6, from the DAOKAI's PCB top up, centred on it: the charge LEDs show
    beside the ESP32's USB window. To refine once the LEDs are measured.
    [animo_v2_BrainBase.stl]
2026-10-22 v2: thin wall instead of a slot over the DAOKAI's LEDs
    A 12 x 5 pocket from inside leaves 0.6 of the +X wall over the DAOKAI's
    charge LEDs; printed in white PETG they glow through it. Generous until
    the LEDs are measured.
    [animo_v2_BrainBase.stl]
2026-10-22 v2: ESP32 cradle without snap lips, rests clear of its pins
    The snap lips were too stiff to give in PETG, and the ledge all round sat
    right under the soldered pin rows. The ESP32 now rests on a strip at its
    -X end and two corner pads at its USB end, so the joints hang free, and is
    held with double-sided tape; the cradle's walls still locate it and its
    -X wall takes the push of a USB plug.
    [animo_v2_BrainBase.stl]
2026-10-22 v2: charging socket cutout 12.40 x 5.79 (+0.40)
    At +0.25 the bought USB-C would not go in: a square hole in PETG round a
    bought part slides at +0.40 (fit coupon), as the switch's cutout shows.
    [animo_v2_BrainLid.stl]
2026-10-23 v2: charging socket cutout sized to its clips: 14.8 x 5.79
    Its clips are wedges on its narrow ends, widest (15.0 across) just under
    the bezel: the cutout's ends sit 0.2 inside them so they bite, the long
    sides a +0.40 slide.
    [animo_v2_BrainLid.stl]
2026-10-23 Docs: the brain's wiring, top view to scale
    DAOKAI against the +X wall, its pads read from the component side; the
    switch on +5 V only; the charging USB-C on VIN; the split board feeding
    the ESP32 and four servo plugs at the cable passage. Fixed colours on
    white so it renders the same on the web.
2026-10-23 Docs: brain wiring with the switch and charging USB-C drawn outside the box
    They sit in the lid; drawn beside the box their wires read clearly.
2026-10-23 Docs: brain wiring shows the JST connectors
    Battery to BAT, charging USB-C to VIN, and the DAOKAI's OUT, whose red
    goes to the switch and black to the split board. The switch is wired
    direct, with slack to lift the lid.
2026-10-25 v2: split board sized in perfboard holes, 6 x 3
    Cut between holes: four servo columns with a spare one at each end, which
    the two slotted posts hold (with the plug block at the board's edge the
    posts met the header). Three rows (GND, +5 V, signal); the plugs sit on
    the floor. A check keeps the header clear of the posts.
    [animo_v2_BrainBase.stl]
2026-10-25 v2: split board 20 long, a 2 x 8 cm perfboard's width
    The 2 x 8 cm perfboard is 20 wide with 6 holes across and a margin at each
    side; cut across only (3 rows), it stays 20. The posts move out to hold its
    ends; the header block clears them by 4.1.
    [animo_v2_BrainBase.stl]
2026-10-25 Docs: the split board, front and back
    Front: the 3 x 4 header in columns 2-5, rows GND / +5 V / signal. Back,
    mirrored: rows 1 and 2 bridged to column 6, where the power wires come in
    and leave for the ESP32; four signal wires to GPIO 4-7.
2026-10-25 v2: split board with its header at one end, two spare columns toward the DAOKAI
    The header went into columns at one end of the six; the board sits so the
    two free columns face the DAOKAI (where the power wires come from) and the
    plug block stays over the cable passage. Header clear of the posts by 1.58.
    [animo_v2_BrainBase.stl]
2026-10-25 Docs: split board with the header at one end, signal wires on the pin stubs
2026-10-26 Firmware: four-channel test for the split board
    Sweeps GPIO 4, 5, 6 and 7 in turn, blinking the channel number first, with
    the Wi-Fi on to keep the DAOKAI awake.
2026-10-26 Firmware: four-channel test that runs on MicroPython 1.29
    Creating a PWM with a duty argument raised "PWM is inactive" and stopped
    the program at start-up. Each channel is now created on its turn, given
    its pulses after, and deinit'ed when done, so only one servo draws at a
    time; the pins idle low.
2026-10-28 v2: output cross 4.90 / 1.90
    4.87 fit on the first hub but three more came out too tight: prints
    scatter by a few hundredths, so take the middle of 4.87 (tight) and 4.97
    (loose).
    [animo_v2_OutputHub.stl]
2026-10-28 firmware: DAOKAI KEY test
    Pulses KEY to GND on GPIO3 every 15 s with the radio off, to see whether
    it keeps the DAOKAI awake below its 50 mA cut-off. The pin only idles as an
    input or pulls low, never drives high.
2026-10-28 firmware: Wi-Fi burst test for the DAOKAI's cut-off
    The DAOKAI has no KEY pad, only its button. Try short Wi-Fi bursts
    (2 s every 15 s) to restart its 30 s low-current timer instead.
    [burst_test.py]
2026-10-28 T-rex v1: legs, feet and tail, with printed cross spigots
    First model on the v2 cube, no LEGO parts: each part carries its own
    cross spigot for the output hub (4.86, and a coupon of three sizes).
    Legs on the side walls, feet one solid of revolution: a 75 mm frontal
    rocker centred on the body, and a fore-aft arc centred 20 above the hip,
    above the centre of mass. Tail: a crossbar with M5 weights on the back
    wall. Firmware with park, walk and frequency / phase sweeps.
    [animo_trex_LegLeft.stl, animo_trex_LegRight.stl, animo_trex_SpigotCoupon.stl, animo_trex_Tail.stl]
2026-10-28 T-rex: a hanging tail that wags, and LEAN in the firmware
    The crossbar didn't look like a tail. The tail now goes back and down
    with an M5 screw and nuts at the tip: the back output's turn wags it.
    It pushes about half as hard; nuts make up for it. Its weight sits
    behind the cube, so LEAN turns both legs together to level the body.
    [animo_trex_Tail.stl]
2026-10-28 T-rex: MuJoCo sim, feet together, a head to balance the tail
    sim/trex_sim.py runs the firmware's gait on the macro's meshes. It found:
    - with a 6 mm gap the cube sat on two edges and the tail could not rock
    it: the feet now meet (1 mm gap), one whole rocker;
    - the tail's weight leans it back onto the tail: a second tail on the
    front wall (the same part) balances it and pumps with it;
    - it rocks most at ~1.0 Hz, not 1.9; tail and head at +-15 deg;
    - walking is very sensitive: 1.0 Hz with the legs 180 deg behind went
    forward, a little off turned or backed.
    The firmware starts from those values and drives the head on GPIO7.
    [animo_trex_LegLeft.stl, animo_trex_LegRight.stl]
2026-10-28 T-rex: robust gait search in the sim
    sim/robust.py scores each gait on its worst case over seven scenarios
    (rhythm +-5 %, floors, masses, a lighter head). Legs 225 deg behind,
    tail and head +-12, legs +-10 at 1.0 Hz walked forward in all seven
    without a fall; the heading still wanders. Firmware and sim defaults
    follow it. sim/ver.ps1 opens the viewer.
2026-10-28 T-rex sim: a nodding head and the user's three-phase gait
    The head nods fore and aft (driven directly; the pin-in-slot is not
    drawn yet), twice a rocking cycle. The gait repeats START (the tail
    starts the rocking), STEPS (nods and legs), STOP (all to rest, the tail
    against the rocking) and a rest; every other round is the mirror image,
    so the start's turn cancels out. Best robust gait: nod at 180 deg, legs
    at 225, head 15, legs +-6: forward 10-24 cm in 40 s in all seven
    scenarios, no falls. The head alone moves it nowhere; it steadies the
    heading.
2026-10-28 T-rex sim: the head pokes forward and tips the body
    The user's head is not a nod: a neck pointing up pokes forward and its
    weight tips the whole body onto the stepping foot. 12 g: 6 g barely tips
    it, 18 g falls on its face standing still. Best robust gait (eight
    scenarios, with a lighter and a heavier head): poke 40 deg at 0, legs
    +-6 at 135: forward 7-21 cm in 40 s in all, no falls, heading within
    31 deg. Now head and legs make the step together; either alone goes
    nowhere.
2026-10-28 T-rex: flatter soles fore and aft go straighter
    The feet were nearly a ball (75 side, 72 fore-aft): one point of
    contact, free to pivot. The macro now draws trial soles
    (ANIMO_SAG_UP=60|150|flat, the same foot length). With the fore-aft
    arc's centre 150 above the hip (R 202), all eight sim scenarios walk
    250-320 mm in 120 s within ~25 deg of straight; the ball scattered
    from 20 to 480 mm in any direction. Flat walks hardly at all.
    sim/paths.py plots the paths.
2026-10-31 Animo walker sim: passive rocking gait, brain-up duck feet
    The gait now comes from side-to-side rocking on doubly curved soles
    (frontal R 130, sagittal R 186, gap 7) with the legs at +-15 deg,
    1.2 Hz, the right leg starting backward (phase 180). The sole outline
    can follow the measured footprint (cap_wide_from/to, cap_heel_x/toe_x).
    - trex_sim.py: doubly curved soles, MG90D torque-speed line
    (servo_curve), rhythm chirp (freq0, chirp_s), sole outline,
    real-time viewer with a short contact trail
    - frontal.py, sagittal.py: idealised single-plane models and plots
    - support.py, tune92.py, hip_freq.py, resonance.py, heading.py,
    sole_trace.py: sweeps and studies, each with its plot script
    -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
    [animo_trex.py]
2026-10-31 Duckling v1: printable legs and feet, firmware
    cad/animo_duck.py draws the simulator's winner for printing: the sole is
    the sim's cap solid (R 130 side to side, R 186 fore and aft, gap 7, hip
    92, rounded outline). Each leg is a plate (on its side, spigot up) and a
    foot (upside down, the sole as the top surface with sharp edges), held by
    two M3x12 that cut their own thread in the foot. Checks: clears the cube
    and the other foot over +-25 deg.
    The sim gets cap_g, the foot's own mass on its solid: the printed foot
    (~22 g at 5 % infill, plate 8 g) walks as before, and with PETG's grip
    (mu 0.5) better, so no rubber needed.
    firmware/duck_walk.py: legs in scissors, +-15 deg at 1.2 Hz, right leg
    s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
    [animo_duck_FootLeft.stl, animo_duck_FootRight.stl, animo_duck_Plate.stl]
2026-11-01 Servo calibration: dial, calibrate firmware, cal.py
    A printed dial held by two Technic pins and a pointer on the cross spigot
    read each output at 1050/1500/1950 us. cal.py keeps the readings per GPIO
    and turns degrees into us; duck_walk.py goes through it, with SIGN from
    the geometry (+ = clockwise seen from outside).
    [animo_dial_Dial.stl, animo_dial_Pointer.stl]
2026-11-01 Firmware: no servo pulses with a computer on the USB
    calibrate.py and duck_walk.py read the ESP32-C3's USB frame counter at
    start; if it moves, a host is there and the servos would draw from the
    USB through the 5V pin, so they get no pulses and the LED blinks fast.
    The servos can stay plugged in while uploading, switch off.
2026-11-01 Printed cross at 4.80: the coupon's fit in the 4.90 hubs
    Duckling plate and dial pointer re-exported.
    [animo_dial_Pointer.stl, animo_duck_Plate.stl]
2026-11-02 Duckling walks: slow start, measured calibration, plate cross
    The rocking now starts on its own: 5 s at 1.0 Hz, then 12 s climbing to
    1.2 Hz. Wall by wall dial readings go in cal.py. The plate's cross has
    its own arm width (1.87) and tip span (4.65), and the M3 pilot is 3.0.
    [animo_duck_FootLeft.stl, animo_duck_FootRight.stl, animo_duck_Plate.stl, animo_duck_SpigotCoupon.stl]
